custom-ds/ptSolar/ptSolar-Breakout/ptSolar-Breakout.kicad_pcb

## KiCad design ptSolar-Breakout/ptSolar-Breakout.kicad_pcb (2025-04-12)

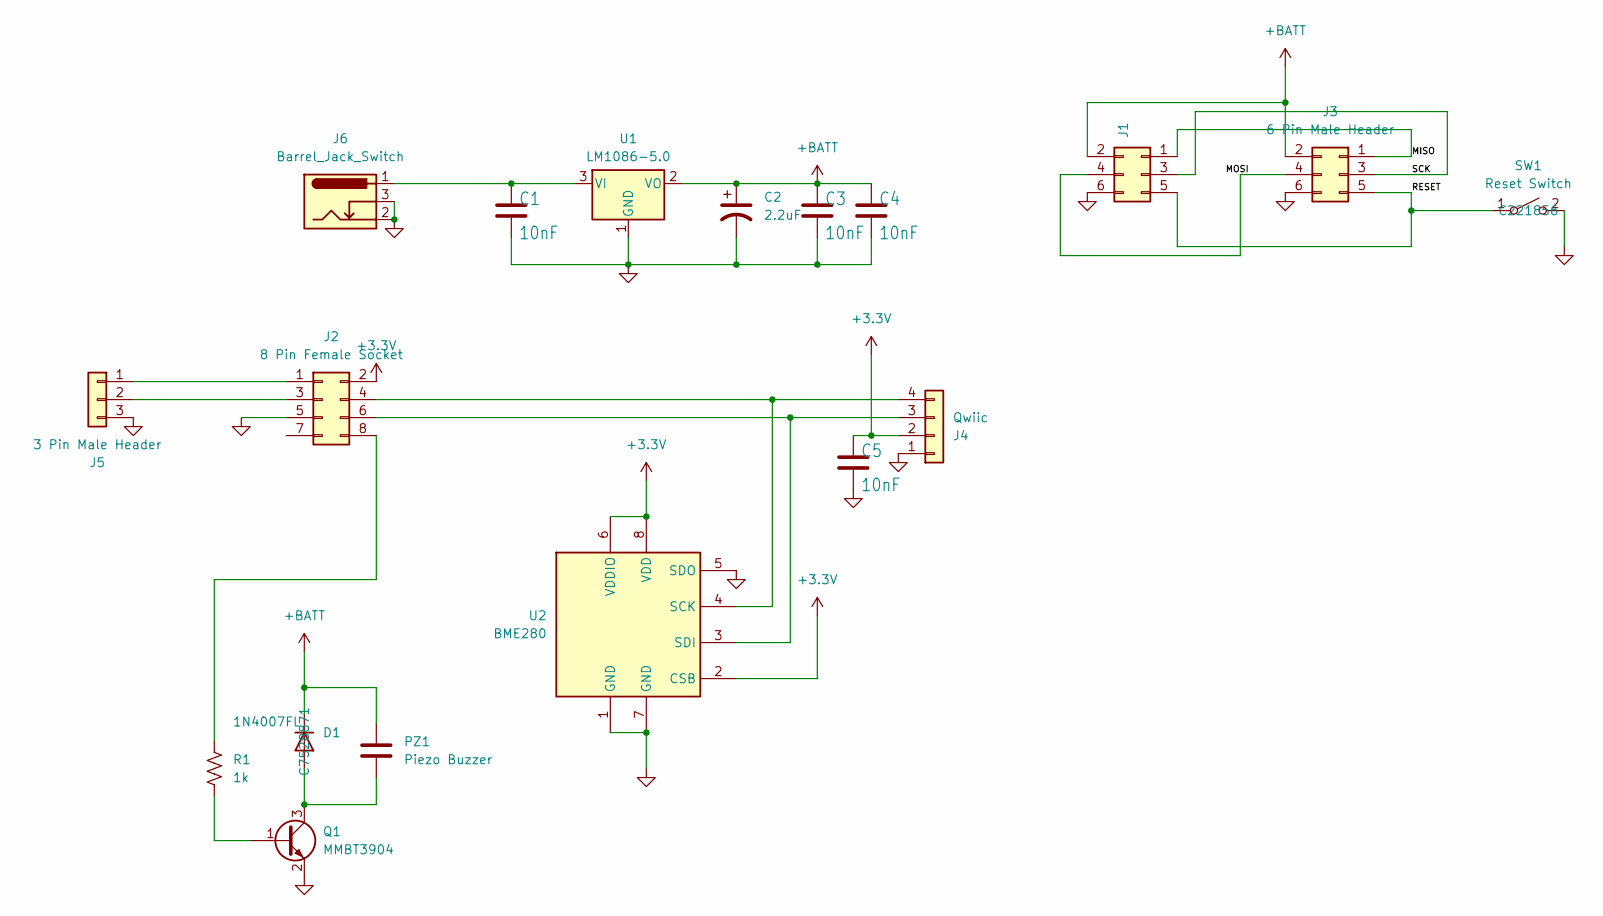
[picture p4: schematic ptSolar-Breakout.kicad_sch]

Parts:
C1, C3, C4, C5: 10nF; C_0805_2012Metric; Digikey 399-1158-1-ND
C2: 2.2uF; C_0805_2012Metric; Digikey 445-1420-1-ND
D1: 1N4007FL; D_SOD-123; Digikey 1655-1N4007FLCT-ND
J1: 6 Pin Female Socket; PinHeader_2x03_P2.54mm_Vertical; Digikey 952-1781-ND
J2: 8 Pin Female Socket; PinHeader_2x04_P2.54mm_Vertical; Digikey 952-1790-ND
J3: 6 Pin Male Header; PinHeader_2x03_P2.54mm_Vertical; Digikey 732-5394-ND
J4: Qwiic; JST_SH_SM04B-SRSS-TB_1x04-1MP_P1.00mm_Horizontal; Digikey 455-1804-1-ND
J5: 3 Pin Male Header; PinHeader_1x03_P2.54mm_Vertical; Digikey 732-5316-ND
J6: Barrel_Jack_Switch; BarrelJack_CLIFF_FC681465S_SMT_Horizontal; Digikey CP-002AHPJCT-ND
PZ1: Piezo Buzzer; Buzzer_TDK_PS1240P02BT_D12.2mm_H6.5mm; Digikey 102-1155-ND
Q1: MMBT3904; SOT-23; Digikey MMBT3904TPMSCT-ND
R1: 1k; R_0805_2012Metric; Digikey 311-1.0KARCT-ND
SW1: Reset Switch; SW_SPST_PTS647_Sx38; Digikey CKN9104CT-ND
U1: LM1086-5.0; TO-263-3_TabPin2; Digikey LM1086ISX-5.0/NOPBCT-ND
U2: BME280; Bosch_LGA-8_2.5x2.5mm_P0.65mm_ClockwisePinNumbering; Digikey 828-1063-1-ND

Connections:
+3.3V: C5.1, J2.2, J4.2, U2.2 (CSB), U2.6 (VDDIO), U2.8 (VDD)
+BATT: C2.1, C3.1, C4.1, D1.1 (K), J1.2, J3.2, PZ1.1, U1.2 (VO)
/MISO: J1.1, J3.1
/MOSI: J1.4, J3.4
/RESET: J1.5, J3.5, SW1.1 (A)
/SCK: J1.3, J3.3
GND: C1.2, C2.2, C3.2, C4.2, C5.2, J1.6, J2.5, J3.6, J4.1, J5.3, J6.2, J6.3, Q1.2 (E), SW1.2 (B), U1.1 (GND), U2.1 (GND), U2.5 (SDO), U2.7 (GND)
unnamed: D1.2 (A), PZ1.2, Q1.3 (C)
unnamed: J2.1, J5.1
unnamed: J2.3, J5.2
unnamed: J2.4, J4.4, U2.4 (SCK)
unnamed: J2.6, J4.3, U2.3 (SDI)
unnamed: J2.8, R1.2
unnamed: Q1.1 (B), R1.1
unnamed: C1.1, J6.1, U1.3 (VI)

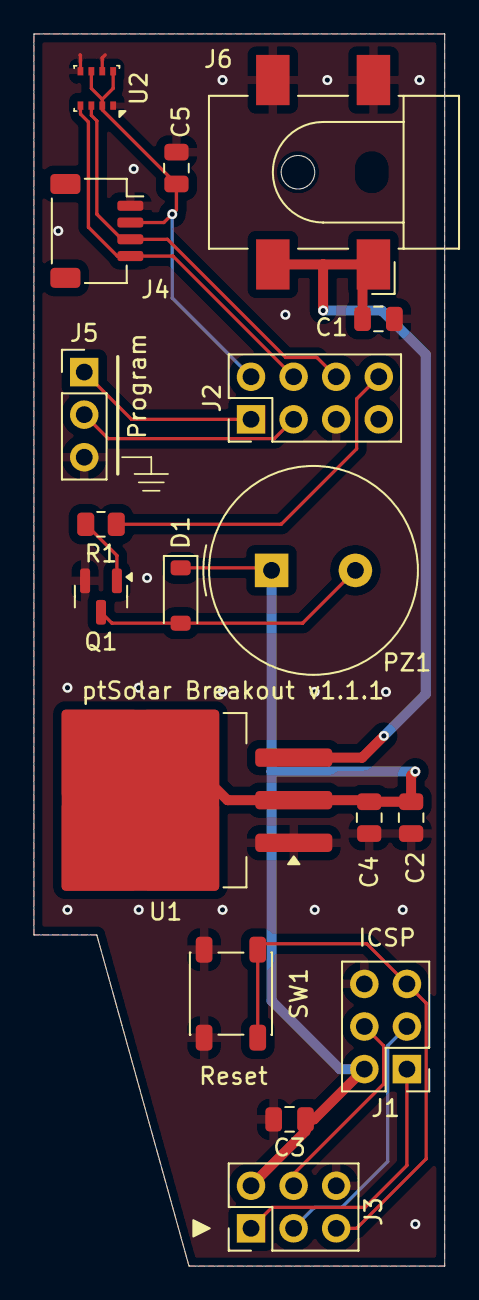
[picture p5: board ptSolar-Breakout.kicad_pcb from above]

Board: 2 copper layers, 24.5 x 73.5 mm, 18 parts (0 on the bottom side), 15 nets.
